baobuibk/NANORACK_V2_EXP_V1.1.2_HW/EXP_V3_CHANGE.docx

- Sửa lỗi Float GND_LASER
- Bỏ đi chân DataOut của ADG1414
- Đổi MCU, check chân trên CUBEIDE
- Bỏ các isolate ICs
- Đổi tín hiệu trên CONN-OBC (Bỏ CAN, Giữ nguyên I2C, thêm SPI, thêm SHEILD, VBUS = 3V3)

Quản lý nguồn trên EXP

EF_12
Default ON

12V

12V_EXP

EF_5

5V_TEMP

GND

3V3

LDO

BUCK

5V

20/03/25

- Thêm serial res: I2C_OBC, SPI, UART
- WDog thêm jumper
- Thêm test point
- Thajch anh 8->25Mhz
