baobuibk/NANORACK_V2_EXP_V1.1.2_HW/02_Schematic_pdf/EXP_HW_V121.pdf

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
# Sheet title:

# Project:

# Revision:

Document No: | Size:
Sheet | of

A3

# Date: 4/13/2025

# SANG HUYNH

V1.2.1

1

1 12

# Sub-system:

# Checked by:

# Approved by:

# Design by:

BAO BUI Q.

# VU PHAM

# BEE-PC1

# Block_Diagram.SchDoc

# NANORACK_EXP_CONTROLLER

D D

C C

B B

A A

# Sheet title:

# Project:

# Revision:

Document No: | Size:
Sheet | of

A3

# Date: 4/13/2025

# SANG HUYNH

V1.2.1

2

2 12

# Sub-system:

# Checked by:

# Approved by:

# Design by:

BAO BUI Q.

# VU PHAM

# BEE-PC1

# HEADER_1.SchDoc

# NANORACK_EXP_CONTROLLER

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
10 10 | 11 11 | 12 12 | 13 13 | 14 14 | 15 15 | 16 16 | 17 17 | 18 18 | 19 19 | 20 20 | 21 21
22 | 22 23 | 23 24 | 24 25 | 25 26 | 26 27 | 27 28 | 28 29 | 29 30 | 30 31 | 31 32 | 32 33 | 33 34 | 34 35 | 35 36 | 36 37 | 37 38 | 38 39 | 39 40 | 40 41 | 41 42 | 42

J1

M80-5114242

GND

IRQ_1 | IRQ_0
GND
GND_CAM | GND_CAM CAM_D0_N | CAM_D0_P
CAM_D1_N | CAM_D1_P GND_CAM | GND_CAM
GND_CAM | GND_CAM CAM_CK_N | CAM_CK_P
CAM_IO1 | | CAM_IO0
CAM_SCL | | CAM_SDA
GND_CAM | | GND_CAM
CM4_SCL | | CM4_SDA
5V_CAM | | GND_CAM

GND_CAM CAM_D0_N
CAM_D0_P
CAM_D1_N
CAM_D1_P
CAM_CK_N
CAM_CK_P
CAM_IO1
CAM_IO0

5V_CAM

CM4_SCL
CM4_SDA

GND

CONNECTOR TO LASER BOARD

CONNECTOR TO PHOTODIODE BOARD

LASER_SPI4_SCK

LASER_SPI4_MOSI

LASER_SPI4_MISO

LASER_ADC1
LASER_ADC2

LASER_SW_INT_CS
LASER_SW_EXT_CS
LASER_DAC_CS
LASER_DAC_LATCH

02 02
04 04
06 06
08 08
10 10
12 12
14 14

01 01
03 03
05 05
07 07
09 09
11 11
13 13

J12

ESQ-107-48-G-D

PHOTO_SPI2_SCK

PHOTO_SPI2_MOSI

PHOTO_SPI2_MISO

PHOTO_PD_CS
PHOTO_ADC_CS
PHOTO_ADC_CONV
PHOTO_ADC_EOC

12V_EXP

12V_EXP

GND

R131 22R

R128 22R

R130 22R

R129 22R

R132 22R
R133 22R
R134 22R

R125 22R

R8 22R
R121 22R
R123 22R
R126 22R

R120 22R
R122 22R
R124 22R

R127 22R

GND

C153
0.22uF/10V

GND

C152
0.22uF/10V

12V_EXP

CAM_SCL
CAM_SDA

3V3

GND_CAM

EXP_I2C2_SCL | EXP_I2C2_SDA

EXP_SPI1_SCK

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
10 10
11 11
12 12
13 13
14 14
15 15
SHIELD1 | S1
SHIELD2 | S2

J3

0532611571

GND

GND

PROTECT_EMI

PROTECT_EMI | PROTECT_EMI
EXP_UART7_RX | EXP_UART7_TX
EXP_SPI1_CS | EXP_SPI1_MISO EXP_SPI1_MOSI

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
SHIELD1 | S1
SHIELD2 | S2

J4

0532610971

R40
4.7k

3V3

R43
4.7k

R44
4.7k
3V3 | 3V3

R42
4.7k

3V3

R41
4.7k

3V3

R54 | 22R
R48 | 22R
R50 | 22R
R52 | 22R
R45 | 22R
R55 | 22R
R49 | 22R
R51 | 22R
R53 | 22R
R47 | 22R

R155
4.7k

3V3

R161 22R/DNP
R162 22R/DNP

RS485_A
RS485_B

D D

C C

B B

A A

# Sheet title:

# Project:

# Revision:

Document No: | Size:
Sheet | of

A3

# Date: 4/13/2025

# SANG HUYNH

V1.2.1

3

3 12

# Sub-system:

# Checked by:

# Approved by:

# Design by:

BAO BUI Q.

# VU PHAM

# BEE-PC1

# HEADER_2.SchDoc

# NANORACK_EXP_CONTROLLER

TEC_1_A
TEC_1_B

TEC_3_A
TEC_3_B

TEC_2_A
TEC_2_B

TEC_4_A
TEC_4_B

HEATER_1_A

HEATER_1_B

HEATER_3_A

HEATER_3_B

CONNECTOR TO TEC & HEATER

NTC1+
NTC1-
NTC2+
NTC2-
NTC3+
NTC3-
NTC4+
NTC4-

HEATER_2_A

HEATER_2_B

HEATER_4_B
HEATER_4_A

CONNECTOR TO NTC

# Harwin Inc. M80-6661642

# - ELECTRICAL:

## CURRENT RATING: 2.2A/CONTACT VOLTAGE RATING: 800V/CONTACT

# - ENVIRONMENTAL:

## TEMPERATURE RANGE: -55°C TO +125°C

# - PHYSICAL:

## PITCH-MATING: 0.079" (2.00mm)

## Harwin Inc. M80-8881606

## WIRE SIZE: 24 AWG

# - MATING:

# - WIRE:

## MAX CURRENT: 2A per Wire ISULATION MATERIAL: PTFE

Hole1 | Hole2 | Hole3 | Hole4

PROTECT_EMI

illustration

NTC5+
NTC5-
NTC6+
NTC6-
NTC7+
NTC7-
NTC8+
NTC8-

# Harwin Inc. M80-6661642

# - ELECTRICAL:

## CURRENT RATING: 2.2A/CONTACT VOLTAGE RATING: 800V/CONTACT

# - ENVIRONMENTAL:

## TEMPERATURE RANGE: -55°C TO +125°C

# - PHYSICAL:

## PITCH-MATING: 0.079" (2.00mm)

## Harwin Inc. M80-8881606

## WIRE SIZE: 24 AWG

# - MATING:

# - WIRE:

## MAX CURRENT: 2A per Wire ISULATION MATERIAL: PTFE

illustration

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
10 10
11 11
12 12
13 13
14 14
15 15
16 16

J7

M80-6661642

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
10 10
11 11
12 12
13 13
14 14
15 15
16 16

J5

M80-6661642

MOUNTING HOLE

D D

C C

B B

A A

# Sheet title:

# Project:

# Revision:

Document No: | Size:
Sheet | of

A3

# Date: 4/13/2025

# SANG HUYNH

V1.2.1

4

4 12

# Sub-system:

# Checked by:

# Approved by:

# Design by:

BAO BUI Q.

# VU PHAM

# BEE-PC1

# POWER.SchDoc

# NANORACK_EXP_CONTROLLER

5V

DS2
RED

GND

R10
2.2k
GND | GND C10 0.22uF/16V

C6
0.22uF/16V

12V

GND | GND | GND | GND C11 0.22uF/10V

C7
0.22uF/10V

5V

GND

R9 10k

R11 3.24k

C5

0.01uF/16V

EN/UVLO 1

OVLO/OVCSEL 2

PG/AUXOFF | 3
PGTH/FLT | 4
IN 5 | OUT | 6 7

9

810

U1 | TPS259470ARPWR R2 | 470k
R6 | 47k
GND | C⁴ ².2nF/16V | C³ ².2nF/16V | R⁷ ¹kGND

GND GND GND GND

12V

GND | GND

GND

DS1
RED

GND

R5
4.7k

12V

R3
10k

EF_12_AUX GND

## 1 GND

## 2 GND

# 3 IN

### 4 IN

### 5 IN

## 6 PAD

7

TVS1
TVS2200DRVR
R1 | 11k | R4
| | 22R
1 | 2 | 3V3
12V_EXP | JP1

5V

GND | GND C20 0.22uF/10V

C16
0.22uF/10V | C19
| 0.22uF/10V

GND

C21
0.22uF/10V

3V3

GND

3V3

R20
2.2k

DS4
YELLOW

GND

EN/UVLO 1

OVLO/OVCSEL 2

PG/AUXOFF | 3
PGTH/FLT | 4
IN 5 | OUT | 6 7

9

810

U3 | TPS259470ARPWR R12 470k

R18 130k

GND | C¹⁵ ².2nF/16V | C¹⁴ ².2nF/16V | R¹⁹ ¹kGND

GND GND GND GND

5V_TEMP

GND | GND

DS3
RED

GND

R16
2.2k

EF_5_EN

R14
10k

EF_5_AUX

SHDN 1

IN 2 | 3,6
OUT | 4
SENSE | 5

GND

U4 TPS7A4533DCQR

GND

5V

# GND GND

## 1 GND

## 2 GND

# 3 IN

### 4 IN

### 5 IN

## 6 PAD

7

TVS2
TVS2200DRVR

R17 10k

GND

R13
120R | R15
| 22R

3V3
1 2

JP2

5V_TEMP

R135
10k

3V3

R149
10k

3V3

+3.3

5V_TEMP

VIN 7

ENA 5 | VSENSE | 4
| BOOT | 1
PH | 8
NC_2 | 2
NC_3 | 3

POWERPAD 9
GND 6

U2

TPS5430DDAR

L1

SRP7050TA-220M | 2 1 | D1
SS54 2 1 | D2
SS54 | 2 1 | D3

SS54

C18
33uF/16V

C17
33uF/16V

C12
33uF/16V

C13
33uF/16V

C8
33uF/16V C9
33uF/16V

C1
33uF/16V
C2
33uF/16V

D D

C C

B B

A A

# Sheet title:

# Project:

# Revision:

Document No: | Size:
Sheet | of

A3

# Date:

# SAMY VE

V1.2.1

5

5 12

# Sub-system:

# Checked by:

# Approved by:

# Design by:

BAO BUI Q.

# VU PHAM

# BEE-PC1

# TEC_DRV.SchDoc

# EXP_HW_V3.PrjPcb

4/13/2025

TEC1_VREF_2.5

GND

GND

ILIM_1

VLIM_1

VLIM_1

ILIM_1

TEC1_CONTROL_VOLT

GND

GND

TEC_1_A

TEC_1_B VDD

5

VREF 6

VTEC 9

VLIM/SD 3

ILIM 4

IN1N 22

IN1P 23

IN2P 24

# IN2N 1 PVINL 16 PVINS ¹⁵

OUT1 21

OUT2 2

LDR 17

EN S/Y 8

SW | 14
SFB | 10
TMPGD | 20
ITEC | 11
AGND | 7
PGNDL | 18 PGNDL | 19 PGNDS | 12 PGNDS | 13 EPAD | 25

U5
ADN8834

VTEC_ADC_1
ITEC_ADC_1

TEC_1_EN

GND GND

GND

GND

GND

TEC1_VREF_2.5

TEC1_VREF_2.5

5V_TEMP

R23
91k

R27
36.5k

R31
6.65k

R35
10k

R21
10R
C22
0.1uF/10V

C26
0.1uF/10V

C28
0.1uF/10V

C24
10uF/10V

C32
10uF/10V

R25
22R | R29 10k
| GND

R33 1k

GND

C30
0.1uF/10V

TEC2_VREF_2.5

GND

GND

ILIM_2

VLIM_2

VLIM_2

ILIM_2

TEC2_CONTROL_VOLT

GND

GND

TEC_2_A

TEC_2_B VDD

5

VREF 6

VTEC 9

VLIM/SD 3

ILIM 4

IN1N 22

IN1P 23

IN2P 24

# IN2N 1 PVINL 16 PVINS ¹⁵

OUT1 21

OUT2 2

LDR 17

EN S/Y 8

SW | 14
SFB | 10
TMPGD | 20
ITEC | 11
AGND | 7
PGNDL | 18 PGNDL | 19 PGNDS | 12 PGNDS | 13 EPAD | 25

U6
ADN8834

VTEC_ADC_2
ITEC_ADC_2

TEC_2_EN

GND GND

GND

GND

GND

5V_TEMP

R24
91k

R28
36.5k

R32
6.65k

R36
10k

R22
10R
C23
0.1uF/10V

C27
0.1uF/10V

C29
0.1uF/10V

C25
10uF/10V

C33
10uF/10V

R26
22R | R30 10k
| GND

R34 1k

GND

C31
0.1uF/10V

TEC3_VREF_2.5

GND

GND

ILIM_3

VLIM_3

VLIM_3

ILIM_3

TEC3_CONTROL_VOLT

GND

GND

TEC_3_A

TEC_3_B VDD

5

VREF 6

VTEC 9

VLIM/SD 3

ILIM 4

IN1N 22

IN1P 23

IN2P 24

# IN2N 1 PVINL 16 PVINS ¹⁵

OUT1 21

OUT2 2

LDR 17

EN S/Y 8

SW | 14
SFB | 10
TMPGD | 20
ITEC | 11
AGND | 7
PGNDL | 18 PGNDL | 19 PGNDS | 12 PGNDS | 13 EPAD | 25

U7
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

GND

C104
0.22uF/10V

C114
0.22uF/10V

GND

C113
0.22uF/10V

GND

C101
0.22uF/10V
C103
0.22uF/10V

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
C102
0.22uF/10V

3V3

GND

C109
0.22uF/10V
C111
0.22uF/10V

3V3

Vcc
+

GND

7

6

5 4 8 U15B

OPA2340UA

Vcc
+

GND

1

2

3 | 4 8 | U16A

OPA2340UA

GND

C110
0.22uF/10V
C112
0.22uF/10V

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
# Sheet title:

# Project:

# Revision:

Document No: | Size:
Sheet | of

A3

# Date: 4/13/2025

# SANG HUYNH

V1.2.1

8

8 12

# Sub-system:

# Checked by:

# Approved by:

# Design by:

BAO BUI Q.

# VU PHAM

# BEE-PC1

# I2C_Sensor.SchDoc

# NANORACK_EXP_CONTROLLER

SENSOR_I2C1_SCL
SENSOR_I2C1_SDA
SENSOR1_EN
GND | SENSOR2_EN

C118
0.22uF/10V
C120
0.22uF/10V

GND

C117
1uF/10V
C119
1uF/10V
R97 | 22R
R94 | 22R
R95 | 22R

R90
4.7k

R91
4.7k

GND

GND | GND

GND

R92
4.7k

R93
4.7k

R99
4.7k

R100
4.7k

R96 22R

SCLA 2
SDAA 3
GND | 4 EN 5
SDAB | 6
SCLB | 7
VCCB | 8 VCCA 1

U17

PCA9508DP,118

SCLA 2
SDAA 3
GND | 4 EN 5
SDAB | 6
SCLB | 7
VCCB | 8 VCCA 1

U18

PCA9508DP,118

3V3
3V3

3V3

3V3

3V3 | 3V3

R101
10k

R98
10k

GND

GND

JST Sales America Inc.

# - ELECTRICAL:

## CURRENT RATING: 1.0A AC/DC/CONTACT VOLTAGE RATING: 50V AC/DC/CONTACT

# - ENVIRONMENTAL:

## TEMPERATURE RANGE: -25°C ~ 85°C

# - MATING:

JST Sales America Inc.

# BM04B-SRSS-TB

## A04SR04SR30K152B

# - PHYSICAL:

## PITCH-MATING: 0.039" (1.00mm)

## WIRE SIZE: 26 AWG

# - WIRE:

## MAX CURRENT: 0.1A per Wire ISULATION MATERIAL: PTFE

1

2

3

### 4 G ⁵,6

J8
BM04B-SRSS-TB

1

2

3

### 4 G ⁵,6

J9
BM04B-SRSS-TB

GND

GND

D D

C C

B B

A A

# Sheet title:

# Project:

# Revision:

Document No: | Size:
Sheet | of

A3

# Date: 4/13/2025

# SANG HUYNH

V1.2.1

9

9 12

# Sub-system:

# Checked by:

# Approved by:

# Design by:

BAO BUI Q.

# VU PHAM

# BEE-PC1

# IR_LED.SchDoc

# NANORACK_EXP_CONTROLLER

GND

GND | GND

R102 0.2R

GND

IR_LED_PWM

GND

C125
470nF/10V

C123
1uF/10V

C124
1uF/10V

L6

82uH

R104
10k

R103
1k

GND 1
GND 2
SET 3
NC 4 | CTRL | 5
| VIN | 6
SW | 7
SW | 8

EPAD

U19 AL8843SP-13

IR_LED_P

D5
1N4148W-TP

C121
4.7uF/10V
1

1
2

2

SHIELD1 S1
SHIELD2 S2

J10

0532610271
GND

5V

5V

GND

C154
0.1uF/10V

IR_LED_P 2 1 D4

SS54

D D

C C

B B

A A

# Sheet title:

# Project:

# Revision:

Document No: | Size:
Sheet | of

A3

# Date: 4/13/2025

# SANG HUYNH

V1.2.1

10

10 12

# Sub-system:

# Checked by:

# Approved by:

# Design by:

BAO BUI Q.

# VU PHAM

# BEE-PC1

# FRAM.SchDoc

# NANORACK_EXP_CONTROLLER

WP 3
HOLD 7

CS 1
SCK 6
SI 5
SO 2
VDD | 8
VSS | 4

U22

MB85RS2MTAPNF-G-BDERE1
GND

C155
0.22uF/10V

C156
0.22uF/10V

3V3
R140
R139 4.7k
4.7k
3V3 | 3V3
R141 | 22R
R142 | 22R
R143 | 22R
R144 | 22R

FRAM_CS
FRAM_SPI6_SCK
FRAM_SPI6_MOSI
FRAM_SPI6_MISO

D D

C C

B B

A A

# Sheet title:

# Project:

# Revision:

Document No: | Size:
Sheet | of

A3

# Date: 4/13/2025

# SANG HUYNH

V1.2.1

11

11 12

# Sub-system:

# Checked by:

# Approved by:

# Design by:

BAO BUI Q.

# VU PHAM

# BEE-PC1

# MCU.SchDoc

# NANORACK_EXP_CONTROLLER

GND

C127
0.22uF/10V
C130
0.22uF/10V

GND

C126
0.22uF/10V
C129
0.22uF/10V
3V3 | 3V3

3V3

R110
10k | 3 | 1 2

4

GND

X1 25MHz

GND | GND

C150
12pF/10V

C151
12pF/10V

OSC0

OSC1

2 1

BT1

BT_NRST
C149
0.22uF/10V

NRST

GND | GND

R10622R

R10722R

WD_WAKE

WD_DONE

R10522R | NRST

R108
16.5k1%
GND | GND | GND | GND

C143
0.22uF/10V
C148
0.22uF/10V

3V3

GND

C138
0.22uF/10V
C146
0.22uF/10V

3V3

VDD 1

GND 2

DELAY/MRST 3

DONE | 4
WAKE | 5
RST | 6

U21

TPL5010DDCR

CONS_UART6_RX
CONS_UART6_TX

GND

SWCLK
NRST

GND

3V3

R113 | 22R
R114 | 22R

R115 22R
R116 22R
R117 22R

R111
2.2k

DS5
GREEN

GND

R112
2.2k

DS6
BLUE

GND

LED_G | LED_B

GND

C137
0.22uF/10V
C145
0.22uF/10V

3V3

GND

C136
0.22uF/10V
C144
0.22uF/10V

3V3

SWDIO

GND

C128
4.7uF/10V

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
PA0-WKUP 22
PA1 23
PA2 24
PA3 25
PA4 28
PA5 29
PA6 30
PA7 31
PA8 67
PA9 68
PA10 69
PA11 70
PA12 71
PA13 72
PA14 76
PA15 77

PB0 34
PB1 35
PB2 36
PB3 89
PB4 90
PB5 91
PB6 92
PB7 93
PB8 95
PB9 96
PB10 46
PB11 47
PB12 51
PB13 52
PB14 53
PB15 54
PC0 | 15
PC1 | 16
PC2 | 17
PC3 | 18
PC4 | 32
PC5 | 33
PC6 | 63
PC7 | 64
PC8 | 65
PC9 | 66
PC10 | 78
PC11 | 79
PC12 | 80
PC13-ANTI_TAMP | 7
PC14-OSC32_IN | 8
PC15-OSC32_OUT | 9
PD0 | 81
PD1 | 82
PD2 | 83
PD3 | 84
PD4 | 85
PD5 | 86
PD6 | 87
PD7 | 88
PD8 | 55
PD9 | 56
PD10 | 57
PD11 | 58
PD12 | 59
PD13 | 60
PD14 | 61
PD15 | 62

U12A

STM32F765VGT7

WD_WAKE

WD_DONE

SWDIO
SWCLK

PHOTO_SPI2_SCK

PHOTO_SPI2_MOSI

PHOTO_SPI2_MISO

EXP_UART7_RX
EXP_UART7_TX

EXP_I2C2_SDA

EXP_I2C2_SCL

SENSOR_I2C1_SCL
SENSOR_I2C1_SDA

EXP_SPI1_SCK

EXP_SPI1_CS

EXP_SPI1_MISO

EXP_SPI1_MOSI | PE0 97
PE1 98
PE2 1
PE3 2
PE4 3
PE5 4
PE6 5
PE7 37
PE8 38
PE9 39
PE10 40
PE11 41
PE12 42
PE13 43
PE14 44
PE15 45
PH0-OSC_IN | 12
PH1-OSC_OUT | 13
NRST | 14
BOOT0 | 94

### 2 of 2

U12B

STM32F765VGT7

OSC1

OSC0

NRST

R46 10k

GND

R38 | 10k/DNP
TEC_SPI3_SCK | 3V3

TEC_SPI3_MOSI

HEATER_PWM4_1
HEATER_PWM4_2
HEATER_PWM4_3
HEATER_PWM4_4

PHOTO_PD_CS
PHOTO_ADC_CS
PHOTO_ADC_CONV

VSS 10
VSS 26
VSS 49
VSS 74
VSS 99

VSSA 19

VBAT 6

VCAP1 48
VCAP2 73
VDD | 11
VDD | 27
VDD | 50
VDD | 75
VDD | 100
VDDA | 21
VREF+ | 20

### 3 of 3

U12C

STM32F765VGT7

GND

GND

L7

10uH/250mA
C76
1uF/10V
C78
0.22uF/10V
GND | GND C79 1uF/10V

C75
0.22uF/10V

GND

C77
1uF/10V
C80
1uF/10V

3V3

3V3

C82
1uF/10V

C81
1uF/10V
GND | GND

3V3

ADC_TEMP1
ADC_TEMP2
ADC_TEMP3
ADC_TEMP4
ADC_TEMP5
ADC_TEMP6

ADC_TEMP7
ADC_TEMP8

SENSOR1_EN
SENSOR2_EN

PHOTO_ADC_EOC

IRQ_1

TEC_2_EN
TEC_3_EN
TEC_4_EN

ADG_CS

EF_5_EN

EF_5_AUX

FRAM_CS

TEC_1_EN

LED_B

LED_G

LASER_SW_INT_CS

LASER_SW_EXT_CS

LASER_DAC_CS

LASER_DAC_LATCH

IR_LED_PWM

EF_12_AUX

LASER_SPI4_SCK

LASER_SPI4_MOSI

LASER_SPI4_MISO

IRQ_0

R109
16.5k1%

1 2

JP3

DAC_nLDAC

DAC_nCS_1

DAC_nCS_2

DAC_nCS_3

DAC_nCS_4

TEC_ADC

LASER_ADC1

LASER_ADC2

FRAM_SPI6_SCK

FRAM_SPI6_MOSI

FRAM_SPI6_MISO

CONS_UART6_TX
CONS_UART6_RX

ADG_IOSCK

ADG_IOMOSI

RS485_USART1_RX

RS485_USART1_TX

RS485_USART1_DE

D D

C C

B B

A A

# Sheet title:

# Project:

# Revision:

Document No: | Size:
Sheet | of

A3

# Date:

# SAMY VE

V1.2.1

12

12 12

# Sub-system:

# Checked by:

# Approved by:

# Design by:

BAO BUI Q.

# VU PHAM

# BEE-PC1

# RS485.SchDoc

# EXP_HW_V3.PrjPcb

4/13/2025

R157 22R

R159 22R

RS485_USART1_RX

RS485_USART1_TX

3V3

GND

R156
1k

R158
120R

R160
1k

3V3

GND

RS485_A

RS485_B

C47
0.1uF/10V

3V3

GND

RO 1

RE 2

DE 3

DI 4

GND | 5
A | 6

B

7

VCC 8

U10

MAX3485EESA+

R167 22R

RS485_USART1_DE

R168
4.7k

3V3
