baobuibk/NANORACK_V2_EXP_V1.1.2_HW/01_DESIGN/EXP_HW_V3/Project Outputs for EXP_HW_V3/EXP_V121.xls

Board Stack Report
Stack Up |  | Layer Stack
Layer | Board Layer Stack | Name | Material | Thickness | Constant
1 |  | Top Overlay |  | 0mm
2 |  | Top Solder | SM-002 | 0.012mm | 4
3 |  | Top Layer |  | 0.04mm
4 |  | Dielectric 1 | PP-022 | 0.2mm | 4.5
5 |  | Mid-Layer 1 | CF-004 | 0.032mm
6 |  | Dielectric2 | Core-042 | 1.04mm | 4.6
7 |  | Mid-Layer 2 | CF-004 | 0.032mm
8 |  | Dielectric3 | PP-022 | 0.2mm | 4.5
9 |  | Bottom Layer |  | 0.04mm
10 |  | Bottom Solder | SM-002 | 0.012mm | 4
11 |  | Bottom Overlay |  | 0mm
 | Height : 1.608mm
