baobuibk/NANORACK_V2_EXP_V1.1.2_HW/03_BOM/EXP_V121_BOM.xlsx

Name | Description | Designator | Quantity | Footprint | Manufacturer 1 | Manufacturer Part Number 1
BT_NRST | Switch button 2 pin | BT1 | 1 | SW1-SMD | ITT C&K | PTS636SK25FSMTRLFS
33uF/16V | CAP TANT 33UF 20% 16V 1206 | C1, C2, C8, C9, C12, C13, C17, C18 | 8 | TANTALUM-SMD-1206 | Kyocera AVX | TCTAL1C336M8R
2.2nF/16V | CAP CER 2200PF 50V X7R 0603 | C3, C4, C14, C15 | 4 | CAP_C_1608X80 | Samsung | CL10B222KB8NNNC
0.01uF/16V | CAP CER 10000PF 50V X7R 0603 | C5 | 1 | CAP_C_1608X80 | Samsung | CL10B103KB8NNNC
0.22uF/16V | CAP CER 0.22UF 25V X7R 0603 | C6, C10 | 2 | CAP_C_1608X80 | Samsung | CL10B224KA8NNNC
0.22uF/10V | CAP CER 0.22UF 25V X7R 0603 | C7, C11, C16, C19, C20, C21, C75, C78, C85, C86, C87, C88, C89, C90, C91, C92, C93, C94, C95, C96, C97, C98, C99, C100, C101, C102, C103, C104, C105, C106, C107, C108, C109, C110, C111, C112, C113, C114, C115, C116, C118, C120, C126, C127, C129, C130, C136, C137, C138, C143, C144, C145, C146, C148, C149, C152, C153, C155, C156 | 59 | CAP_C_1608X80 | Samsung | CL10B224KA8NNNC
0.1uF/10V | CAP CER 0.1UF 25V X7R 0603 | C22, C23, C26, C27, C28, C29, C30, C31, C34, C35, C38, C39, C40, C41, C42, C43, C46, C47, C48, C49, C50, C51, C84, C122, C139, C154 | 26 | CAP_C_1608X80 | Samsung | CL10B104KA8NNNC
10uF/10V | CAP CER 10UF 25V X5R 0603 | C24, C25, C32, C33, C36, C37, C44, C45 | 8 | CAP_C_1608X80 | Samsung | CL10A106MA8NRNC
1uF/10V | CAP CER 1UF 25V X7R 0603 | C76, C77, C79, C80, C81, C82, C117, C119, C123, C124 | 10 | CAP_C_1608X80 | Samsung | CL10B105KA8NNNC
4.7uF/10V | CAP CER 4.7UF 16V X7R 0603 | C83, C121, C128 | 3 | CAP_C_1608X80 | Murata | GRM188Z71C475KE21J
470nF/10V | CAP CER 0.47UF 16V X7R 0603 | C125 | 1 | CAP_C_1608X80 | Samsung | CL10B474KO8NNNC
12pF/10V | CAP CER 12PF 50V C0G/NP0 0603 | C150, C151 | 2 | CAP_C_1608X80 | Samsung | CL10C120JB81PNC
SS54 | DIODE SCHOTTKY 60V 3A DO214AA | D1, D2, D3, D4 | 4 | DO214-AC-SMA | EVVO | SS54
1N4148W-TP | DIODE GEN PURP 100V 300MA SOD123 | D5 | 1 | SOD-123 | MCC | 1N4148W-TP
RED | LED RED CLEAR 0603 SMD | DS1, DS2, DS3 | 3 | LED-0603-BLUE | Wurth Electronics | 150060RS75000
YELLOW | LED YELLOW CLEAR 0603 SMD | DS4 | 1 | LED-0603-BLUE | Wurth Electronics | 150060YS75000
GREEN | LED GREEN CLEAR 0603 SMD | DS5 | 1 | LED-0603-BLUE | Wurth Electronics | 150060GS75000
BLUE | LED BLUE CLEAR 0603 SMD | DS6 | 1 | LED-0603-BLUE | Wurth Electronics | 150060BS75000
hole_space |  | Hole1, Hole2, Hole3, Hole4 | 4 | HOLE_SPACE
M80-5114242 | CONN HEADER VERT 42POS 2MM | J1 | 1 | M80-5114242 | Harwin | M80-5114242
0532611571 | CONN HEADER SMD R/A 15POS 1.25MM | J3 | 1 | 0532611571 | Molex | 53261-1571
0532610971 | CONN HEADER SMD R/A 9POS 1.25MM | J4 | 1 | 0532610971 | Molex | 53261-0971
M80-6661642 | CONN HEADER SMD R/A 16POS 2MM | J5, J7 | 2 | M80-6661642 | Harwin | M80-6661642
JP5 | WR-PHD 2.54 mm Angled Socket Header | J6 | 1 | JP5-D1C
BM04B-SRSS-TB | CONN HEADER SMD 4POS 1MM | J8, J9 | 2 | BM04B-SRSS-TB | JST | BM04B-SRSS-TBT(LF)(SN)
0532610271 | CONN HEADER SMD R/A 2POS 1.25MM | J10 | 1 | 0532610271 | Molex | 53261-0271
JP3 | WR-PHD 2.54 mm Angled Socket Header | J11 | 1 | JP3-D1C
ESQ-107-48-G-D | CONN SOCKET 14POS 0.1 GOLD PCB | J12 | 1 | ESQ-107-37-G-D | Samtec | ESQ-107-48-G-D
jumper2 |  | JP1, JP2 | 2 | JUMPER
jumper2 |  | JP3 | 1 | JUMPER2
SRP7050TA-220M | FIXED IND 22UH 2.5A 170 MOHM SMD | L1 | 1 | PSM6050 | Bourns | SRP7050TA-220M
1uH | FIXED IND 1UH 4A 38 MOHM SMD | L2, L3, L4, L5 | 4 | L-SMD-M-3.5x3.5x2mm | Bourns | SRP3020TA-1R0M
82uH | SRR4828A-820M | L6 | 1 | L-SMD-M-4.8x4.8x2.8mm | Bourns | SRR4828A-820M
10uH/250mA | FIXED IND 10UH 300MA 600MOHM SMD | L7 | 1 | L-SMD-0603 | TDK | MLZ1608N100LT000
AO3400A | MOSFET N-CH 30V 5.7A SOT23-3L | Q1, Q2, Q3, Q4 | 4 | SOT23-13_2 | Alpha & Omega Semiconductor | AO3400A
11k | RES SMD 11K OHM 1% 1/10W 0603 | R1 | 1 | RES_C_1608X60 | Panasonic | ERJ-3EKF1102V
470k | RES SMD 470K OHM 1% 1/10W 0603 | R2, R12 | 2 | RES_C_1608X60 | Panasonic | ERJ-3EKF4703V
10k | RES SMD 10K OHM 1% 1/10W 0603 | R3, R9, R14, R17, R29, R30, R35, R36, R46, R62, R63, R64, R65, R70, R71, R76, R77, R82, R83, R88, R89, R98, R101, R104, R110, R135, R138, R145, R149, R151, R152 | 31 | RES_C_1608X60 | Panasonic | ERJ-3EKF1002V
22R | RES SMD 22 OHM 1% 1/10W 0603 | R4, R8, R15, R25, R26, R45, R47, R48, R49, R50, R51, R52, R53, R54, R55, R66, R67, R68, R69, R72, R73, R74, R75, R78, R79, R80, R81, R84, R85, R86, R87, R94, R95, R96, R97, R105, R106, R107, R113, R114, R115, R116, R117, R118, R119, R120, R121, R122, R123, R124, R125, R126, R127, R128, R129, R130, R131, R132, R133, R134, R141, R142, R143, R144, R154, R157, R159, R167 | 68 | RES_C_1608X60 | Panasonic | ERJ-3EKF22R0V
4.7k | RES SMD 4.7K OHM 1% 1/10W 0603 | R5, R40, R41, R42, R43, R44, R90, R91, R92, R93, R99, R100, R139, R140, R153, R155, R163, R164, R165, R166, R168 | 21 | RES_C_1608X60 | Panasonic | ERJ-3EKF4701V
47k | RES SMD 47K OHM 1% 1/10W 0603 | R6 | 1 | RES_C_1608X60 | Panasonic | ERJ-3EKF4702V
1k | RES SMD 1K OHM 1% 1/10W 0603 | R7, R19, R33, R34, R103, R148, R150, R156, R160 | 9 | RES_C_1608X60 | Panasonic | ERJ-3EKF1001V
2.2k | RES SMD 2.2K OHM 1% 1/10W 0603 | R10, R16, R20, R111, R112 | 5 | RES_C_1608X60 | Panasonic | ERJ-3EKF2201V
3.24k | RES SMD 3.24K OHM 1% 1/10W 0603 | R11 | 1 | RES_C_1608X60 | Panasonic | ERJ-3EKF3241V
120R | RES SMD 120 OHM 1% 1/10W 0603 | R13, R58, R59, R60, R61, R158 | 6 | RES_C_1608X60 | Panasonic | ERJ-3EKF1200V
130k | RES SMD 130K OHM 1% 1/10W 0603 | R18 | 1 | RES_C_1608X60 | Panasonic | ERJ-3EKF1303V
10R | RES SMD 10 OHM 1% 1/10W 0603 | R21, R22, R37, R39 | 4 | RES_C_1608X60 | Panasonic | ERJ-3EKF10R0V
91k | RES SMD 91K OHM 1% 1/10W 0603 | R23, R24, R56, R57 | 4 | RES_C_1608X60 | Panasonic | ERJ-3EKF9102V
36.5k | RES SMD 36.5K OHM 1% 1/10W 0603 | R27, R28, R136, R137 | 4 | RES_C_1608X60 | Panasonic | ERJ-3EKF3652V
6.65k | RES SMD 6.65K OHM 1% 1/10W 0603 | R31, R32, R146, R147 | 4 | RES_C_1608X60 | Panasonic | ERJ-3EKF6651V
10k/DNP | RES SMD 10K OHM 1% 1/10W 0603 | R38 | 1 | RES_C_1608X60 | Panasonic | ERJ-3EKF1002V
0.2R | RES 0.2 OHM 1% 1W 1206 | R102 | 1 | RES_C_3216X70 | Yageo | PE1206FRF470R2L
16.5k1% | RES SMD 16.5K OHM 1% 1/10W 0603 | R108, R109 | 2 | RES_C_1608X60 | Panasonic | ERJ-3EKF1652V
22R/DNP | RES SMD 22 OHM 1% 1/10W 0603 | R161, R162 | 2 | RES_C_1608X60 | Panasonic | ERJ-3EKF22R0V
TVS2200DRVR | UNIDIR PRECISION SURGE DIODE | TVS1, TVS2 | 2 | TVS2200 | Texas Instruments | TVS2200DRVR
TPS259470ARPWR | IC ELECTRONIC FUSE 10VQFN | U1, U3 | 2 | VQFN-HR-10 | Texas Instruments | TPS259470ARPWR
TPS5430DDAR | IC REG BUCK ADJ 3A 8SOPWR | U2 | 1 | TPS5430DDAR | Texas Instruments | TPS5430DDAR
TPS7A4533DCQR | IC REG LINEAR 3.3V 1.5A SOT223-6 | U4 | 1 | SOT223_6 | Texas Instruments | TPS7A4533DCQR
ADN8834 | IC THERMO COOLER DRIVER 24LFCSP | U5, U6, U7, U8 | 4 | ADN8834 | Analog Devices | ADN8834ACPZ-R2
ADG1414BCPZ-REEL7 | IC SW SPST-NOX8 11.5OHM 24LFCSP | U9 | 1 | ADG1414BCPZ-REEL7 | Analog Devices | ADG1414BCPZ-REEL7
MAX3485EESA+ | IC TRANSCEIVER HALF 1/1 8SOIC | U10 | 1 | SOIC8_3.9mm | Maxim | MAX3485EESA+
MCP4921-E/SN | 12 Bit Digital to Analog Converter, P/N: MCP4921-E/SN | U11, U20, U23, U24 | 4 | SO8 | Microchip | MCP4921-E/SN
STM32F765VGT7 | IC MCU 32BIT 1MB FLASH 100LQFP | U12 | 1 | LQFP100_STM | STMicroelectronics | STM32F765VGT7
OPA2340UA | IC CMOS 2 CIRCUIT 8SOIC | U13, U14, U15, U16 | 4 | SO8 | Texas Instruments | OPA2340UA/2K5
PCA9508DP,118 | IC REDRIVER I2C HOTSWAP 8TSSOP | U17, U18 | 2 | TSOP8 | NXP Semiconductors | PCA9508DP,118
AL8843SP-13 | IC LED DRIVER RGLTR PWM 3A 8SO | U19 | 1 | SO8_EPAD | Diodes | AL8843SP-13
TPL5010DDCR | IC OSC PROG TIMER TSOT23-6 | U21 | 1 | TPL5010DDCR | Texas Instruments | TPL5010DDCR
MB85RS2MTAPNF-G-BDERE1 | FRAM _Ferroelectric RAM_ Memory IC 2Mb _256K x 8_ SPI 40MHz 8-SOP | U22 | 1 | MB85RS2MTAPNF-G-BDERE1 | Fujitsu | MB85RS2MTAPNF-G-BDERE1
25MHz | Crystal, 8 MHz, -30 to 85 degC, 3.2 x 2.5 x 0.9 mm SMD | X1 | 1 | XTAL_ECS-250-12-33Q-JES-TR | ECS International | ECS-250-12-33Q-JES-TR
