baobuibk/NANORACK_V2_EXP_V1.1.2_HW/05_SMT/EXP_V121_ASM_FILE.pdf

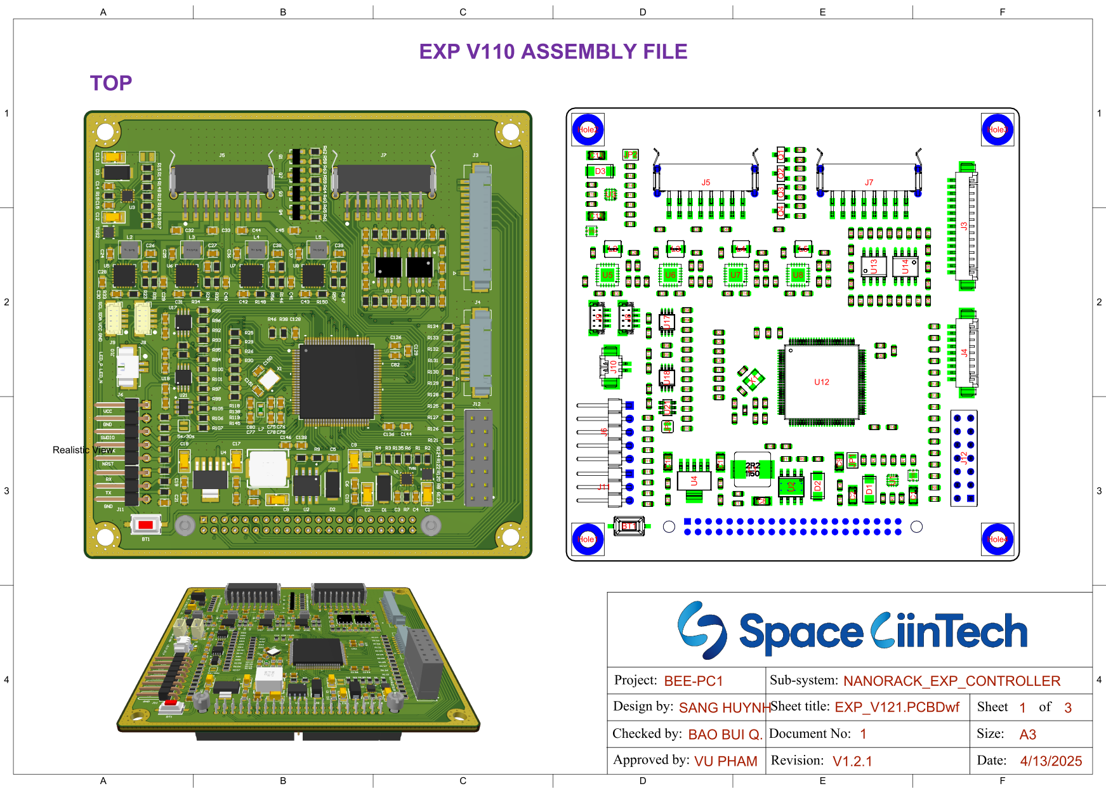
[picture p1: page 1]

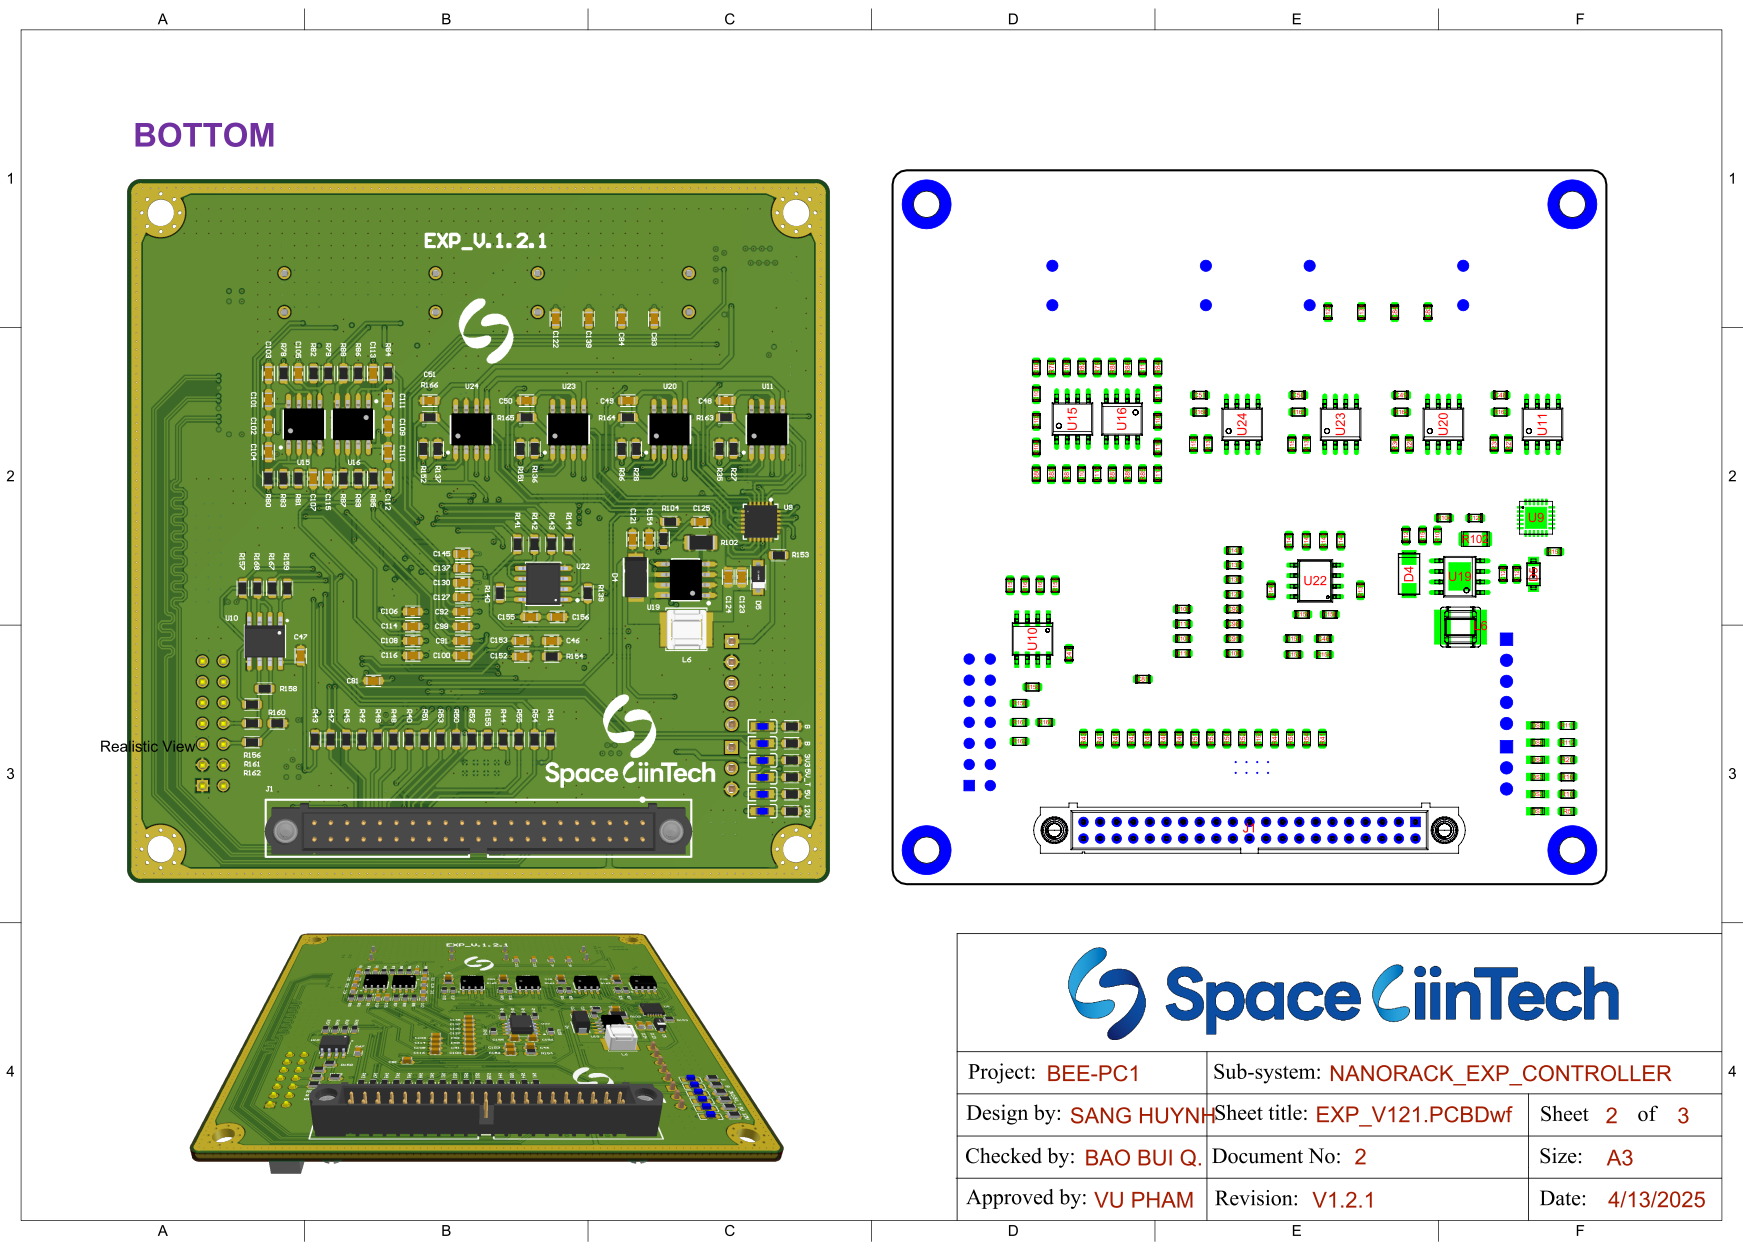
[picture p2: page 2]

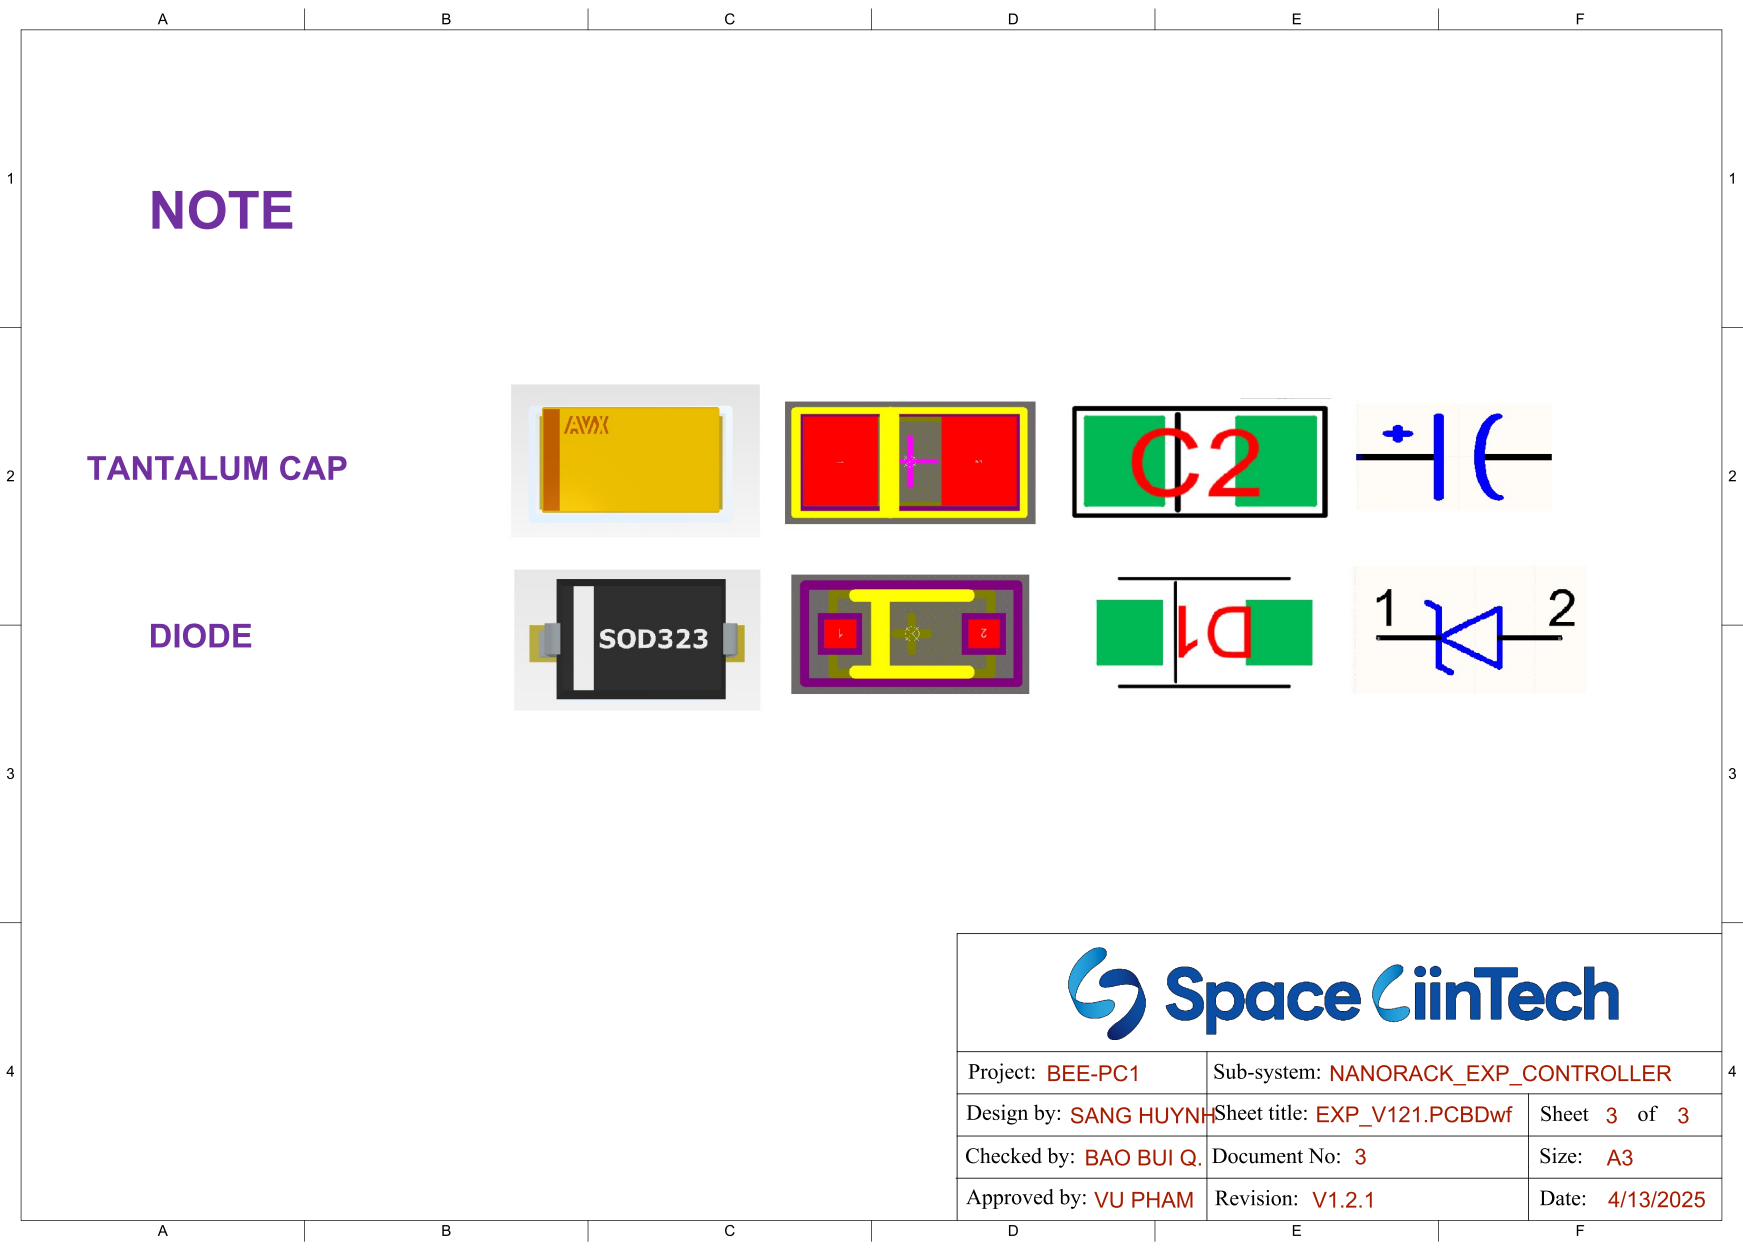
[picture p3: page 3]
