baobuibk/NANORACK_V2_EXP_V1.1.2_HW/(list of files, drawings)

Other design files:
0_LAB_LIB/LABLIB.PcbLib
01_DESIGN/EXP_HW_V3/Block_Diagram.SchDoc
01_DESIGN/EXP_HW_V3/EXP_HW_V3.PcbLib
01_DESIGN/EXP_HW_V3/EXP_HW_V3.PrjPcb
01_DESIGN/EXP_HW_V3/EXP_HW_V3.SchLib
01_DESIGN/EXP_HW_V3/EXP_V121.PcbDoc
01_DESIGN/EXP_HW_V3/FRAM.SchDoc
01_DESIGN/EXP_HW_V3/HEADER_1.SchDoc
01_DESIGN/EXP_HW_V3/HEADER_2.SchDoc
01_DESIGN/EXP_HW_V3/HEATER.SchDoc
01_DESIGN/EXP_HW_V3/I2C_Sensor.SchDoc
01_DESIGN/EXP_HW_V3/IR_LED.SchDoc
01_DESIGN/EXP_HW_V3/MCU.SchDoc
01_DESIGN/EXP_HW_V3/NTC.SchDoc
01_DESIGN/EXP_HW_V3/POWER.SchDoc
01_DESIGN/EXP_HW_V3/RS485.SchDoc
01_DESIGN/EXP_HW_V3/TEC_DRV.SchDoc
