baobuibk/NANORACK_V2_EXP_V1.1.2_HW/(commit log)

2025-03-23 EXP | 23/03/25
    [Block_Diagram.SchDoc, EXP_HW_V3.PrjPcb, EXP_HW_V3.SchLib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]
2025-03-24 EXP | 24/03/2024 | 15:32
    [MCU.SchDoc, TEC_DRV.SchDoc]
2025-03-25 EXP | 25/03/25 | 23:21
    [FRAM.SchDoc, MCU.SchDoc, POWER.SchDoc, TEC_DRV.SchDoc]
2025-03-28 EXP | 28/03/25 | 17:17
    [EXP_HW_V3.PrjPcb, HEADER_1.SchDoc, POWER.SchDoc, TEC_DRV.SchDoc]
2025-04-08 EXP | 08/04/25 | 10:00
    [EXP_HW_V3.PrjPcb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]
2025-04-10 EXP_V121 | 10/04/25 | 15:48
    [Block_Diagram.SchDoc, EXP_HW_V3.PcbLib, EXP_HW_V3.PrjPcb, EXP_HW_V3.SchLib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]
2025-04-10 EXP_V121 | 10/04/25 | 21:10
    [EXP_HW_V3.PcbLib, EXP_HW_V3.PrjPcb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]
2025-04-10 EXP_V121 | 10/04/25 | 23:23
    [EXP_HW_V3.PcbLib, EXP_HW_V3.PrjPcb, EXP_HW_V3.SchLib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]
2025-04-11 EXP_V121 | 11/04/25 | 14:17
    [EXP_HW_V3.PrjPcb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]
2025-04-13 EXP_V121 | 13/04/25 | 15:38
    [EXP_HW_V3.PrjPcb, EXP_V121.PcbDoc, EXP_V121_BOM.xlsx, HEADER_1.SchDoc, Pick Place for EXP_V121.csv]
